croberson94/ILCS/README.md

# ILCS

## About
The Intelligent Lighting Control System (ILCS) is a Senior Design Capstone project made
to determine the proper lighting conditions for life on space stations in orbit. 

## Features
This project consists of providing a circadian lighting system in connection
with multiple sensors for various rooms of a 3D-printed scaled spacecraft model. 

## Download

## FAQ
