croberson94/ILCS/NTP_Clock/README.md

# NTP_Clock

## About
The NTP_Clock is 4Duino code that uses a connection to request and receive time from a NTP server using the User Datagram Protocol (UDP) communication protocol. The NTP_Clock base code can be found through the [4Duino Projects](http://www.4duino.com/ntp-clock/) . 

## Updates
This program is currently being modified to fit the needs of the ILCS Project.
