croberson94/ILCS/LaTeX Report/display/4Duino.png

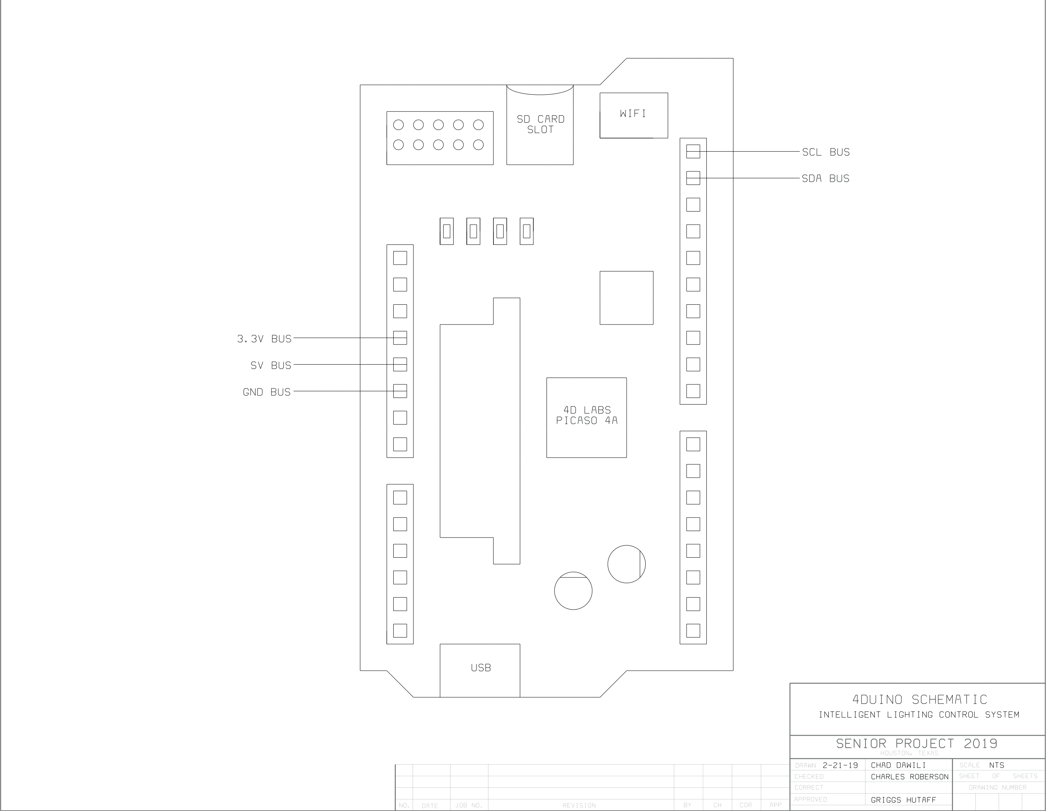
LaTeX Report/display/4Duino.png
