croberson94/ILCS/LaTeX Report/display/20190222_162111.jpg

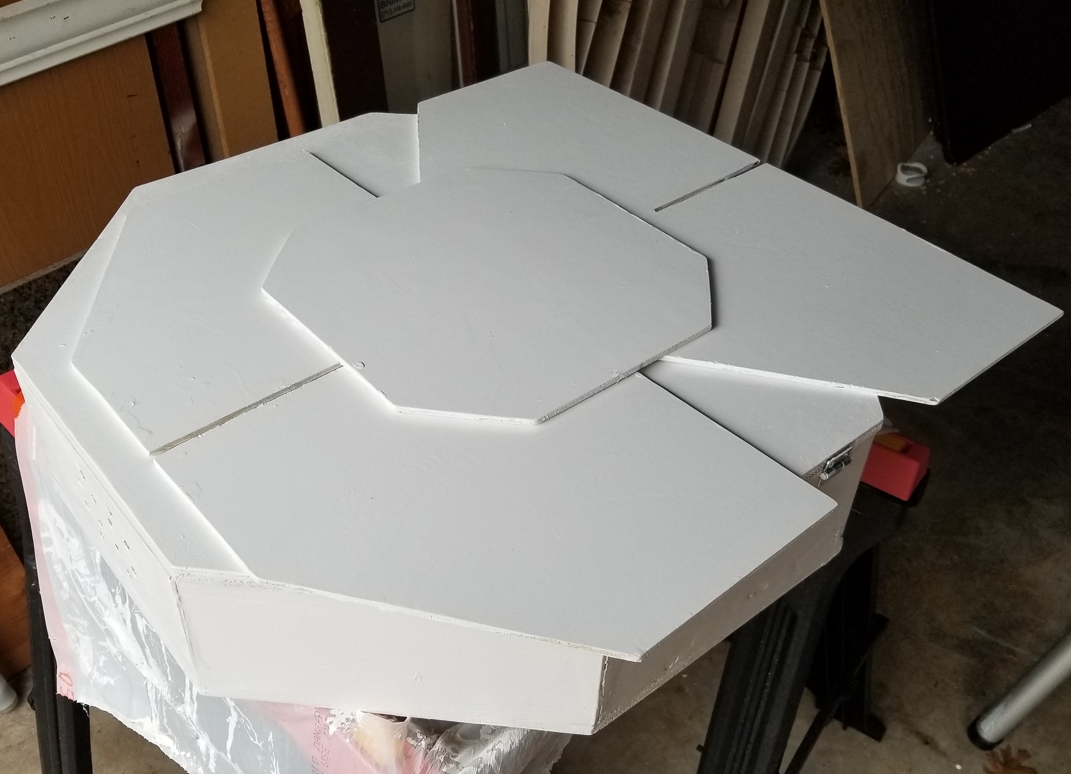
LaTeX Report/display/20190222_162111.jpg
