croberson94/ILCS/LaTeX Report/display/20190222_164352.jpg

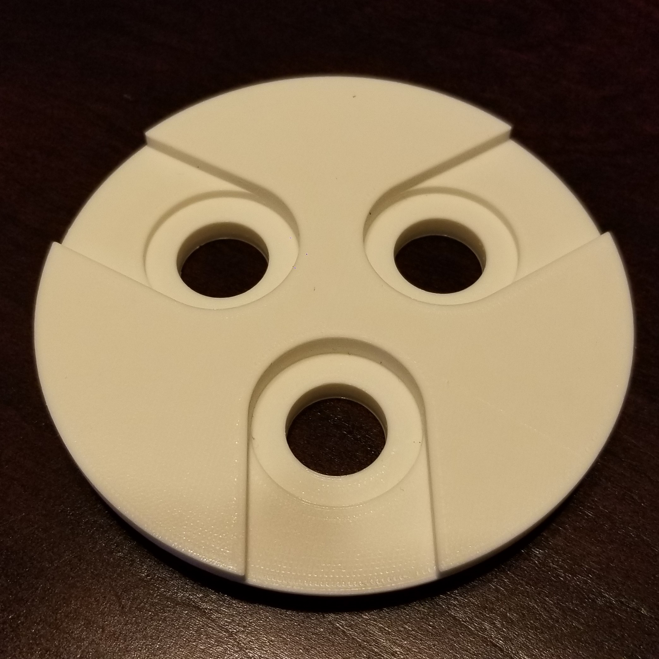
LaTeX Report/display/20190222_164352.jpg
