croberson94/ILCS/LaTeX Report/display/20190222_164402.jpg

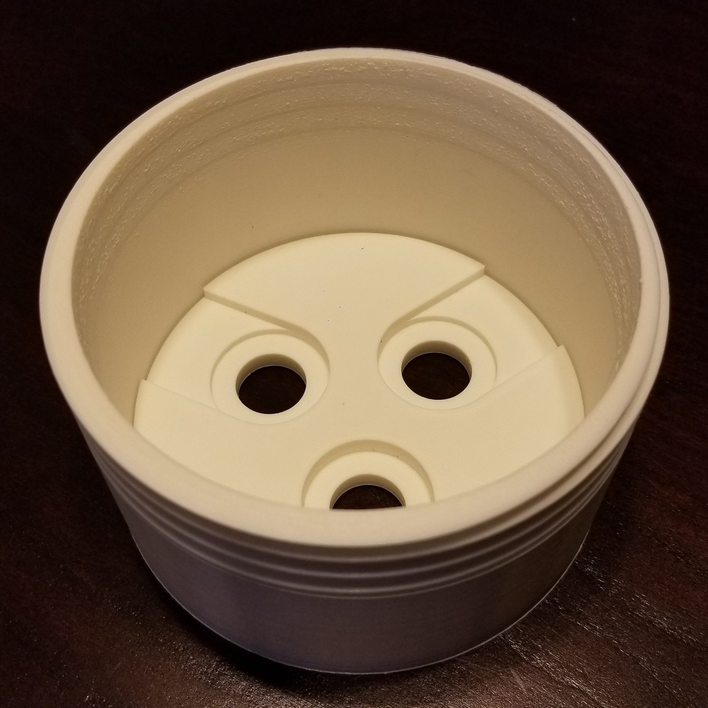
LaTeX Report/display/20190222_164402.jpg
