croberson94/ILCS/LaTeX Report/display/Arduino.png

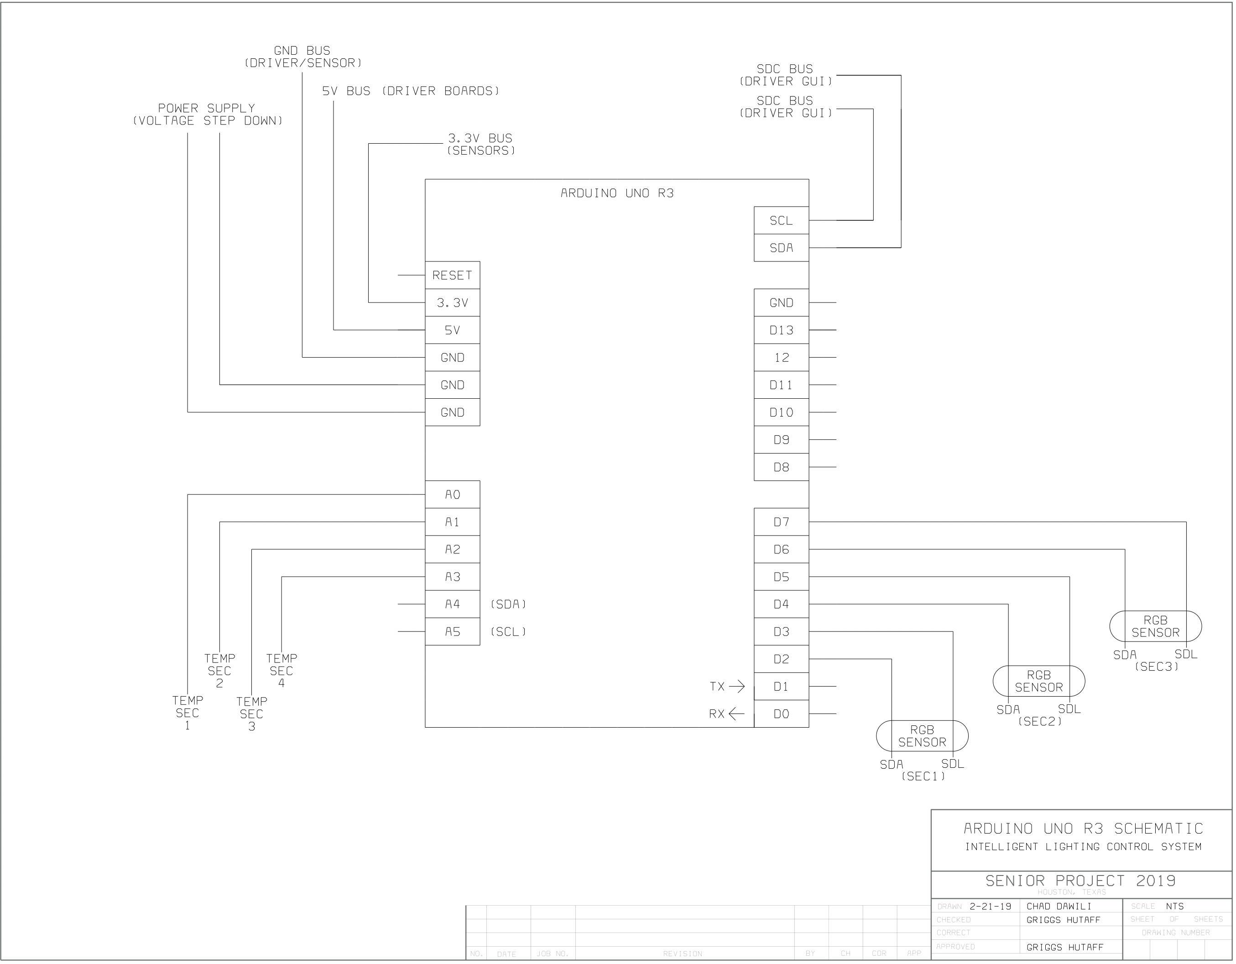
LaTeX Report/display/Arduino.png
