croberson94/ILCS/LaTeX Report/display/display model.PNG

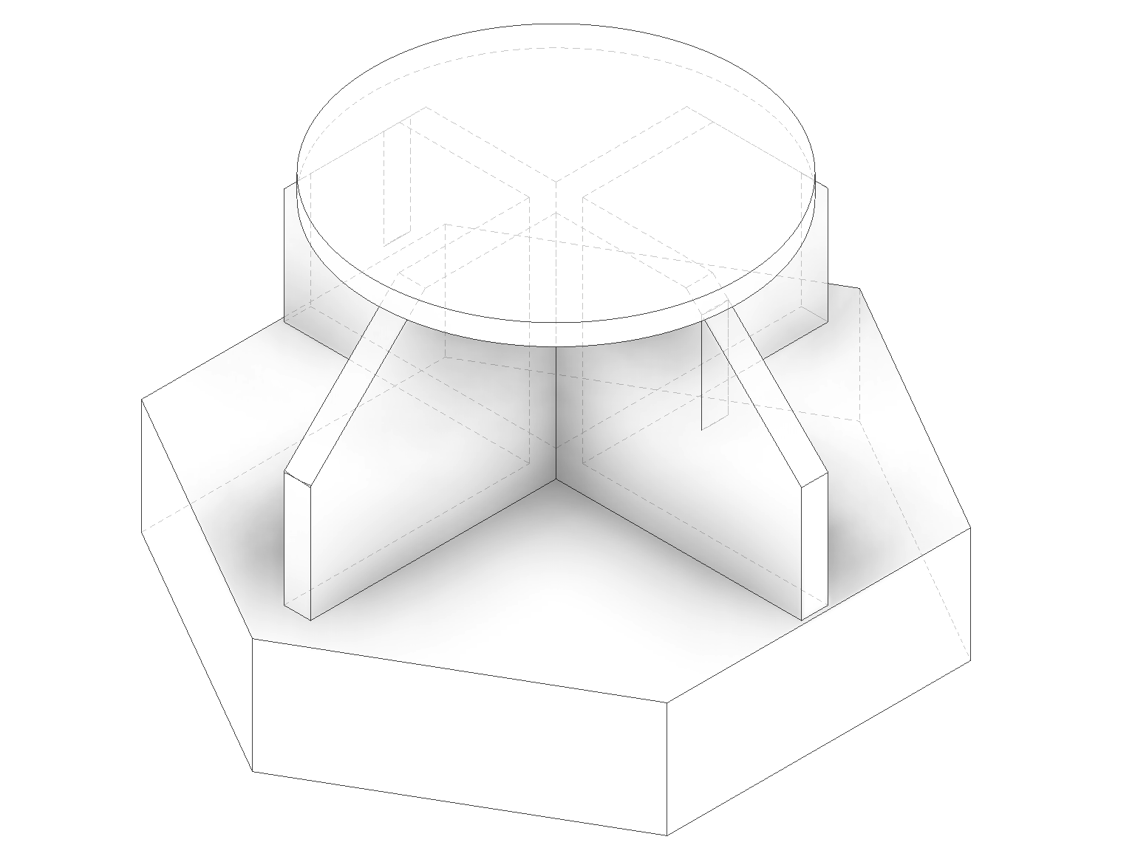
LaTeX Report/display/display model.PNG
