croberson94/ILCS/LaTeX Report/display/Infineon.png

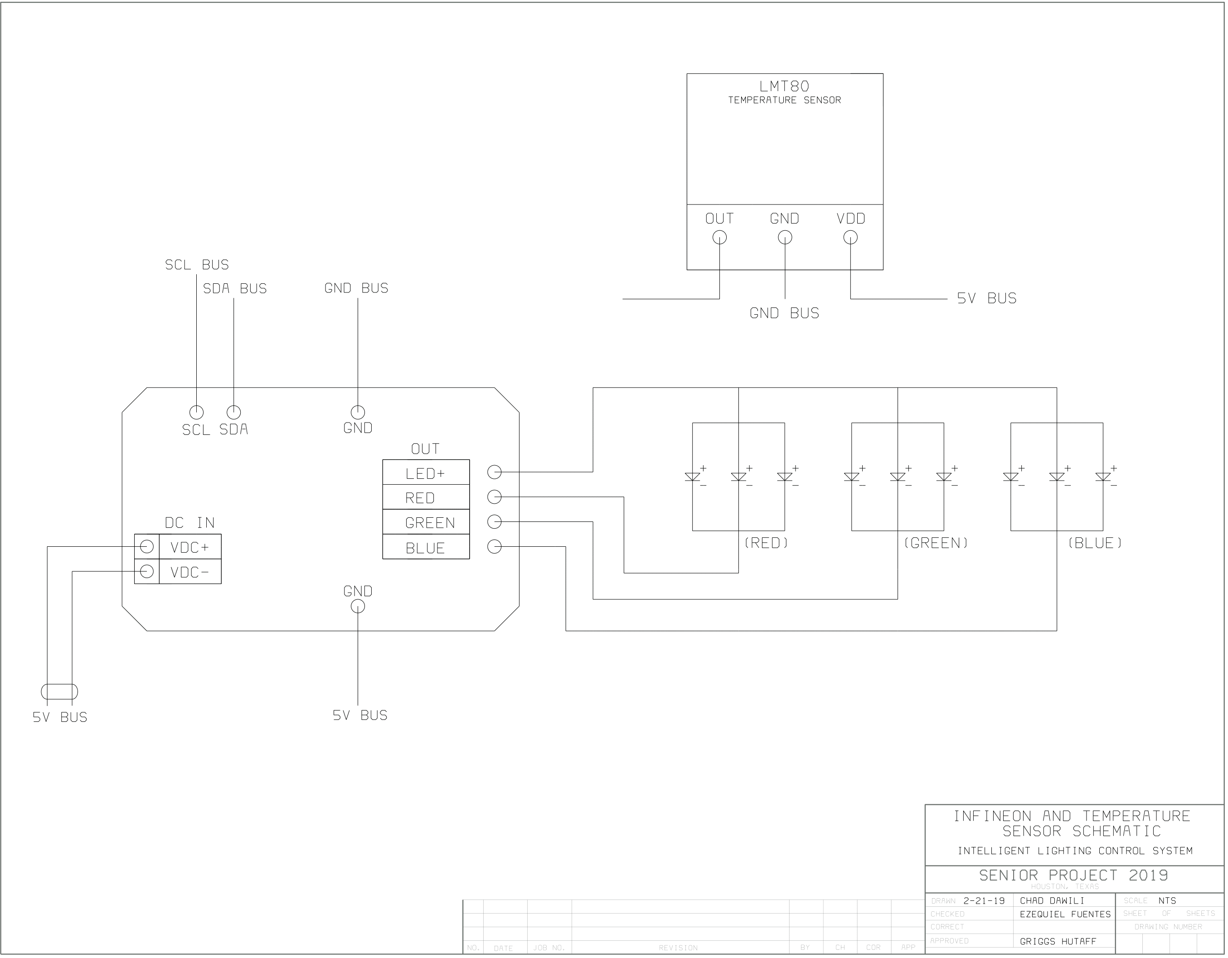
LaTeX Report/display/Infineon.png
