croberson94/ILCS/LaTeX Report/display/LightSensor.png

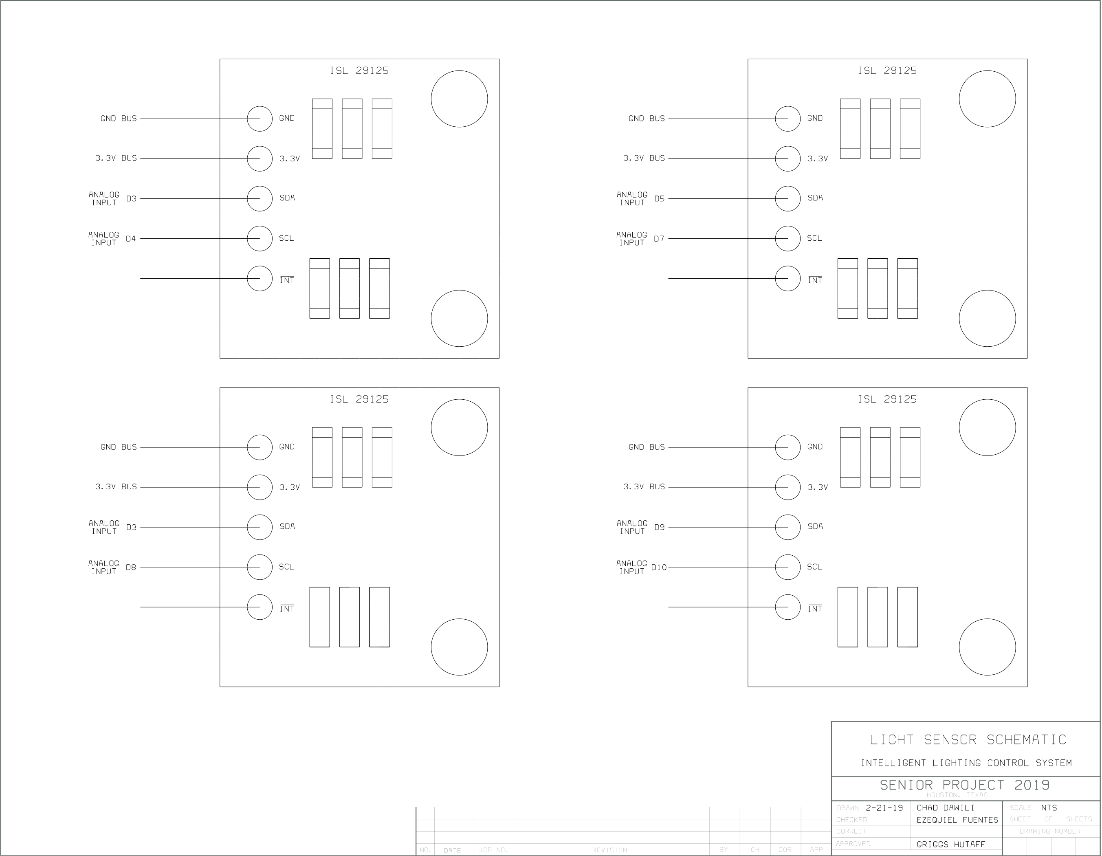
LaTeX Report/display/LightSensor.png
