croberson94/ILCS/LaTeX Report/display/model.jpg

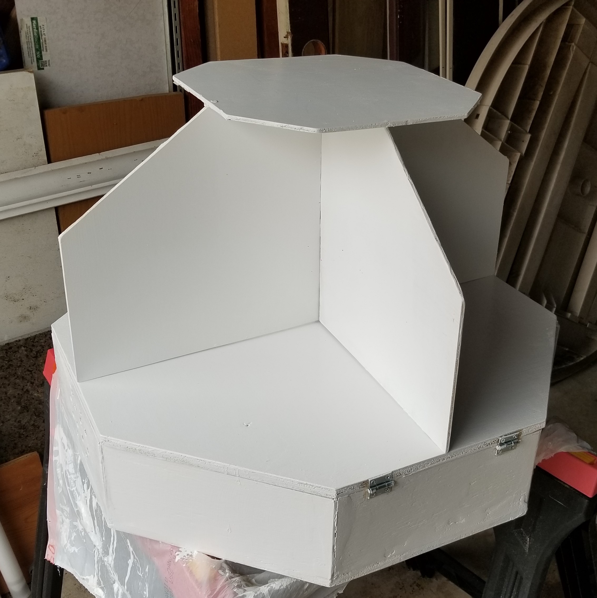
LaTeX Report/display/model.jpg
