croberson94/ILCS/LaTeX Report/display/Part1revised.PNG

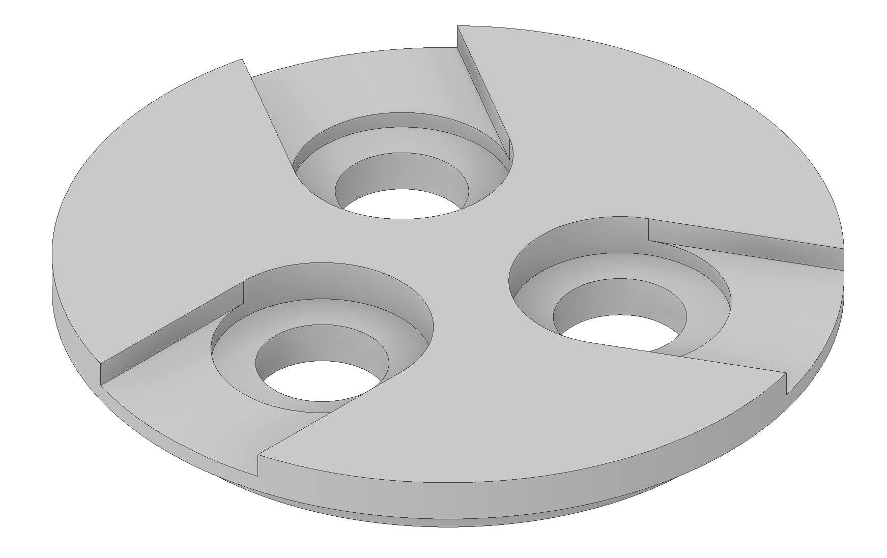
LaTeX Report/display/Part1revised.PNG
