croberson94/ILCS/LaTeX Report/display/Part1revisedwire.PNG

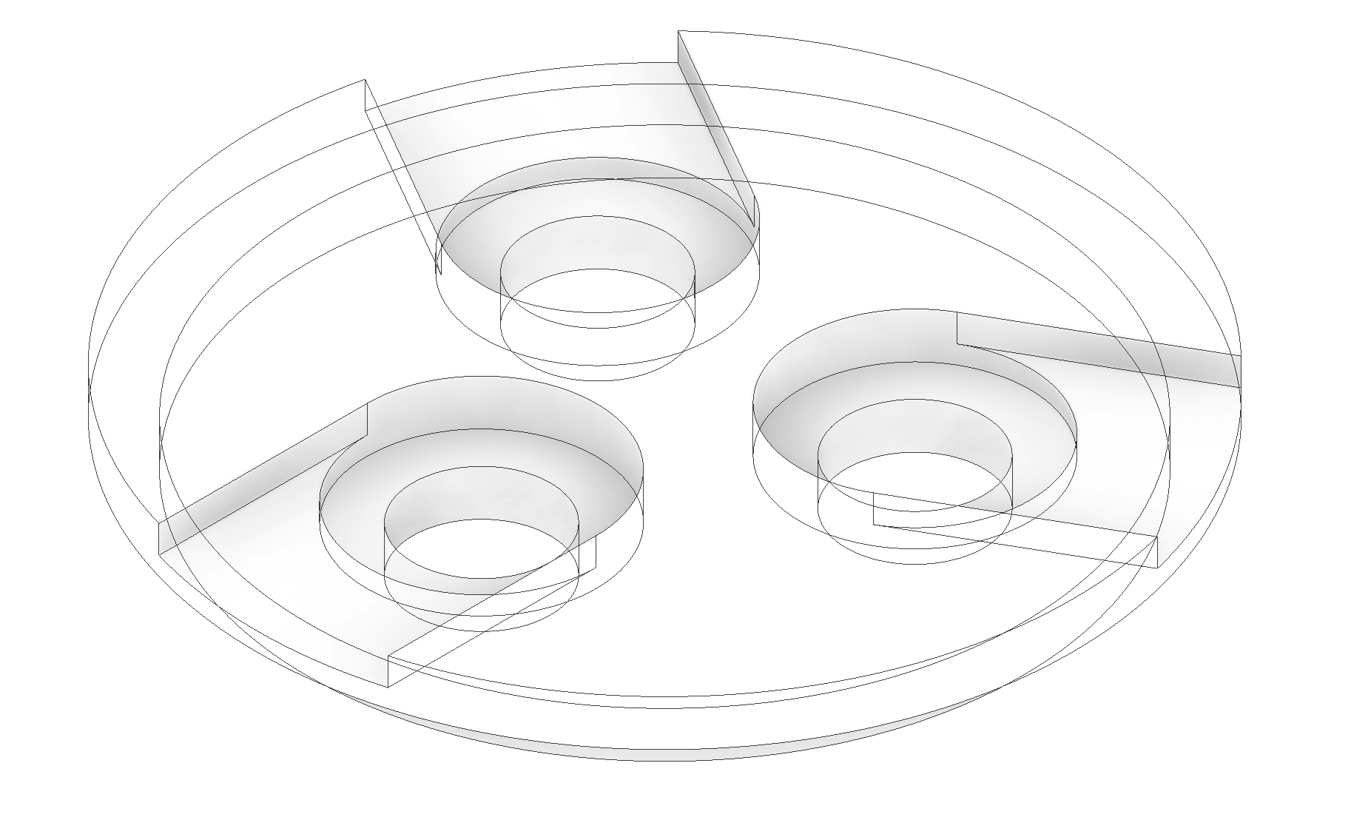
LaTeX Report/display/Part1revisedwire.PNG
