croberson94/ILCS/LaTeX Report/display/Part2revised.PNG

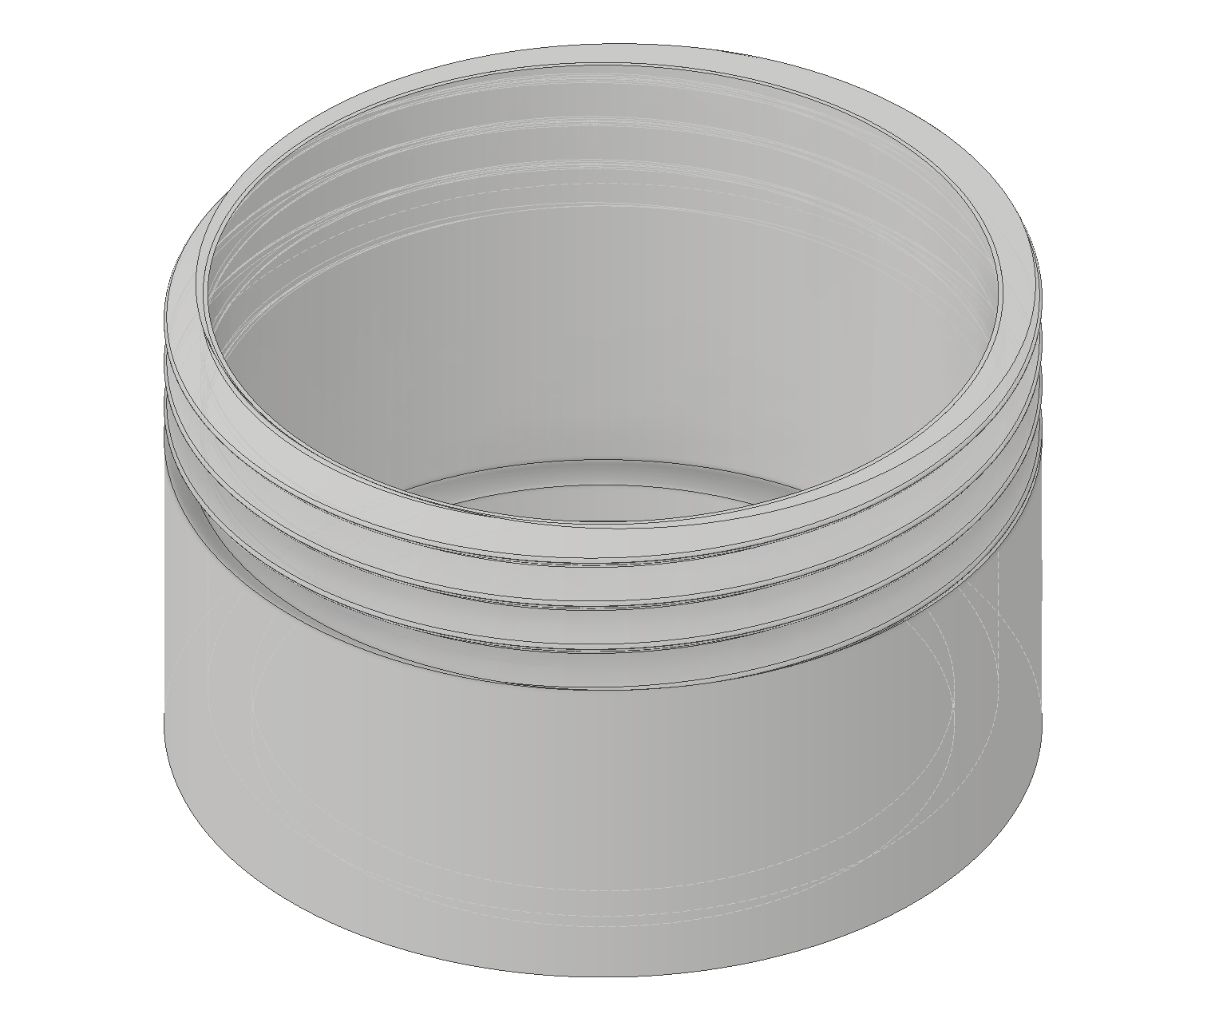
LaTeX Report/display/Part2revised.PNG
