croberson94/ILCS/LaTeX Report/display/Part2revisedwire.PNG

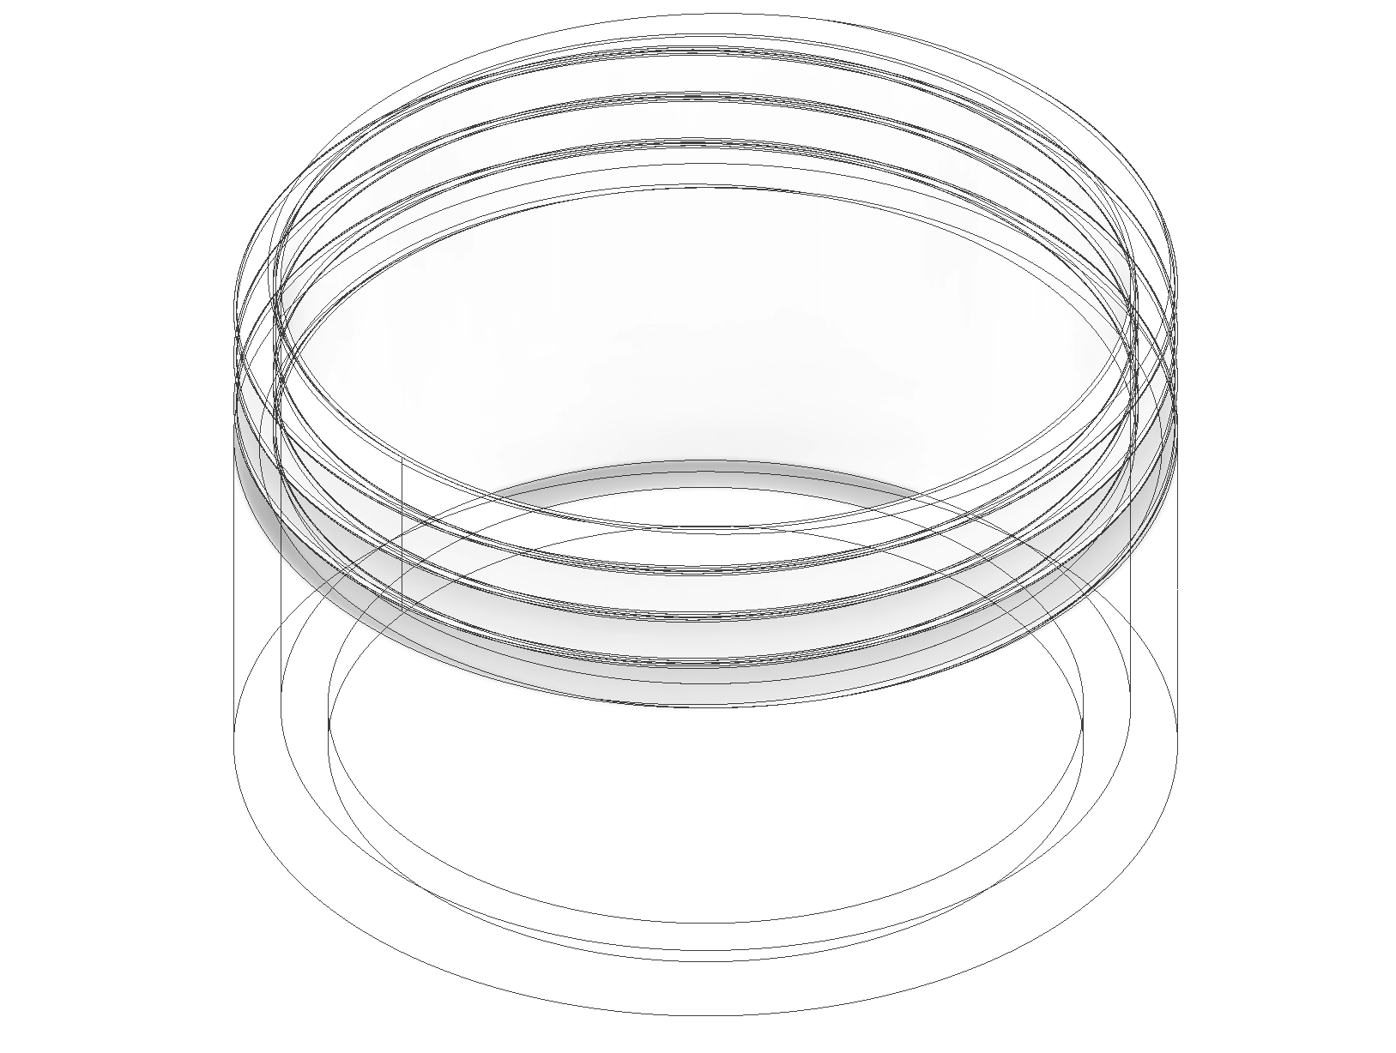
LaTeX Report/display/Part2revisedwire.PNG
