croberson94/ILCS/LaTeX Report/display/Part3revised.PNG

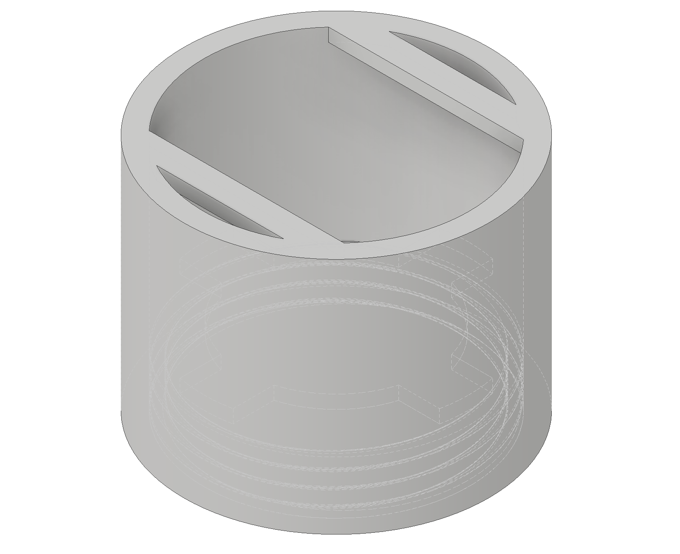
LaTeX Report/display/Part3revised.PNG
