croberson94/ILCS/LaTeX Report/display/Part3revisedwire.PNG

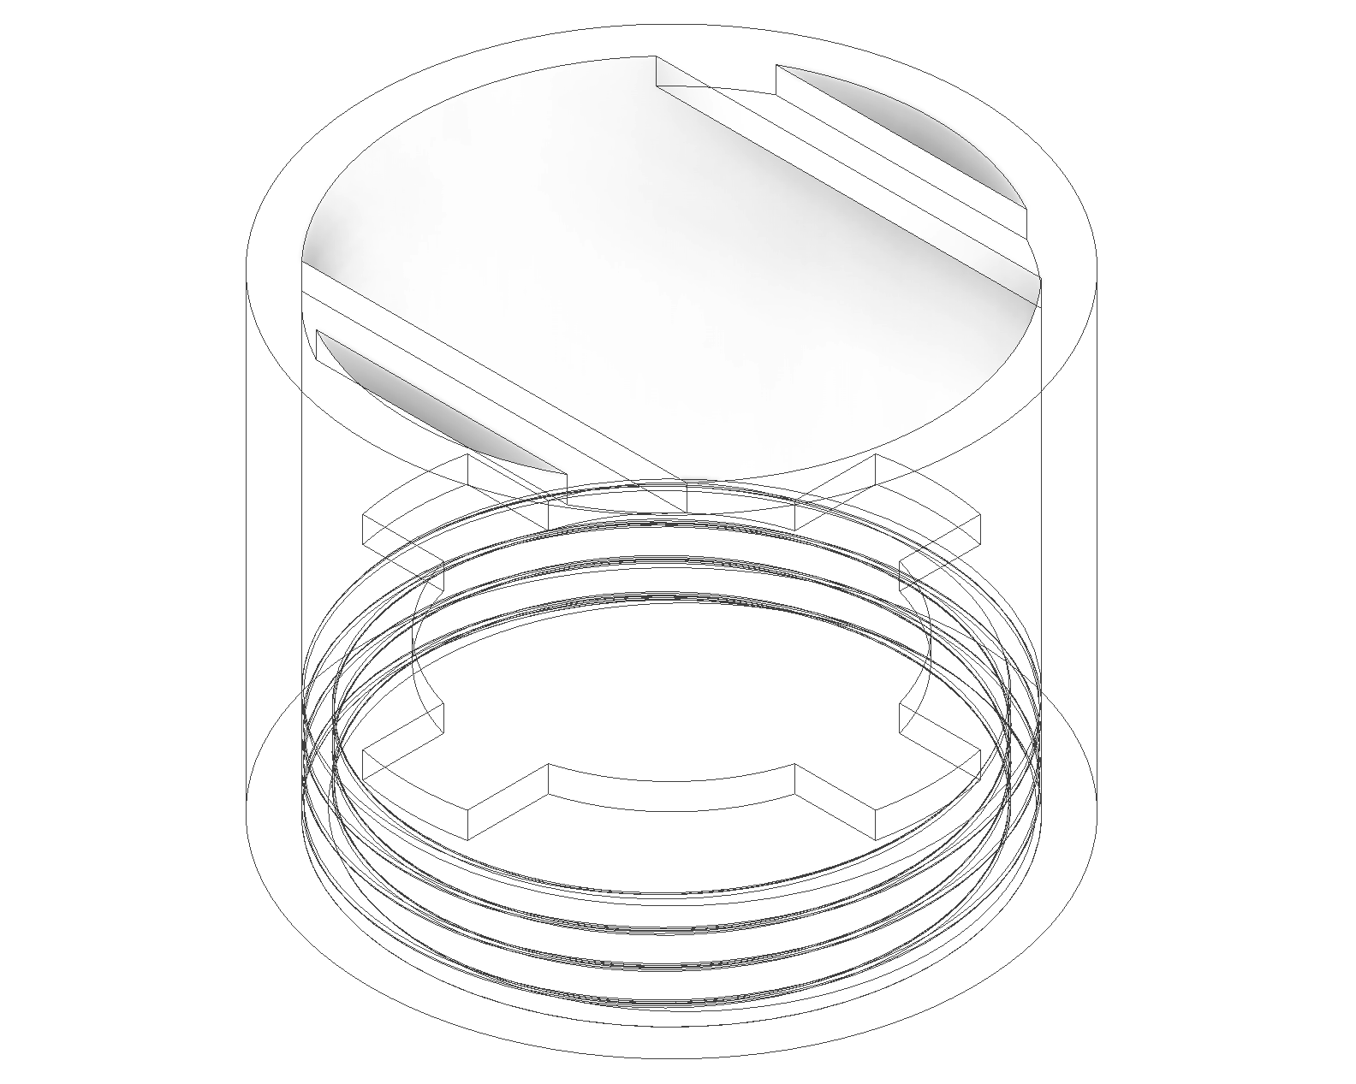
LaTeX Report/display/Part3revisedwire.PNG
