croberson94/ILCS/LaTeX Report/display/PowerSupply.png

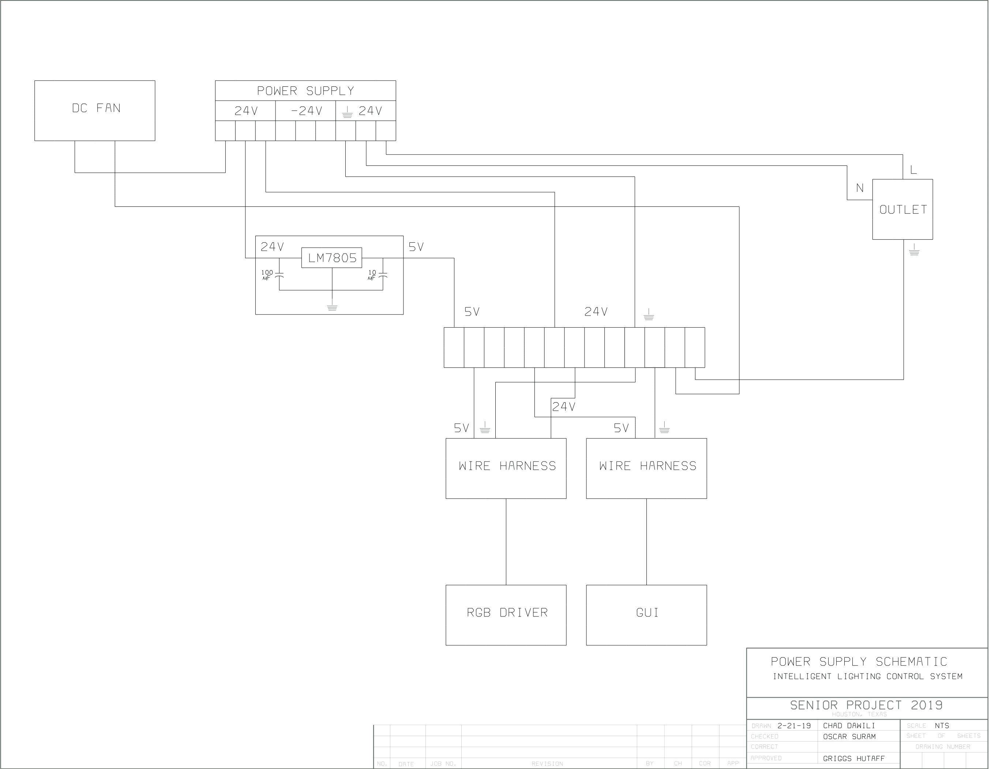
LaTeX Report/display/PowerSupply.png
