croberson94/ILCS/LaTeX Report/display/winbutton_final_release.PNG

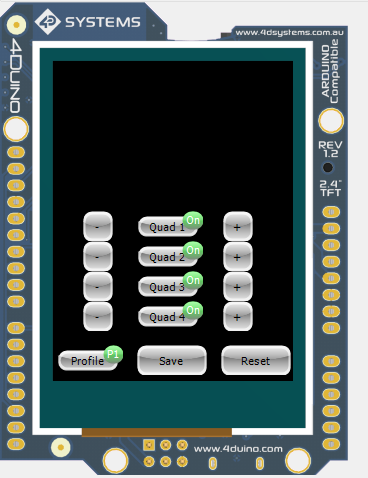
LaTeX Report/display/winbutton_final_release.PNG
