croberson94/ILCS/LaTeX Report/imgs/Buck.PNG

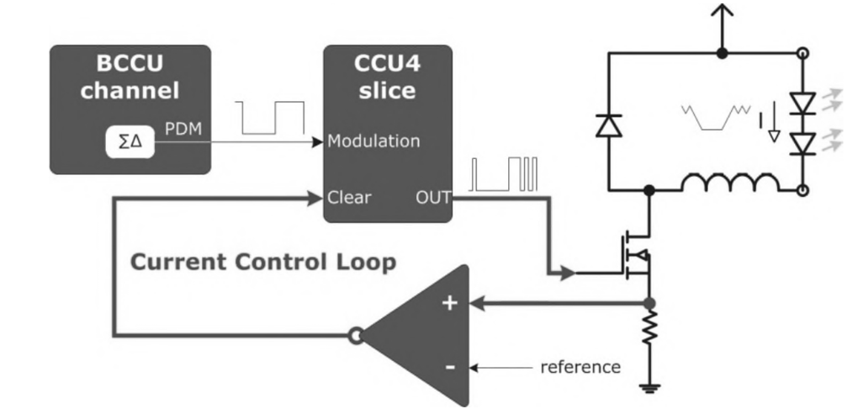
LaTeX Report/imgs/Buck.PNG
