croberson94/ILCS/LaTeX Report/imgs/ILCS_Flowchart.png

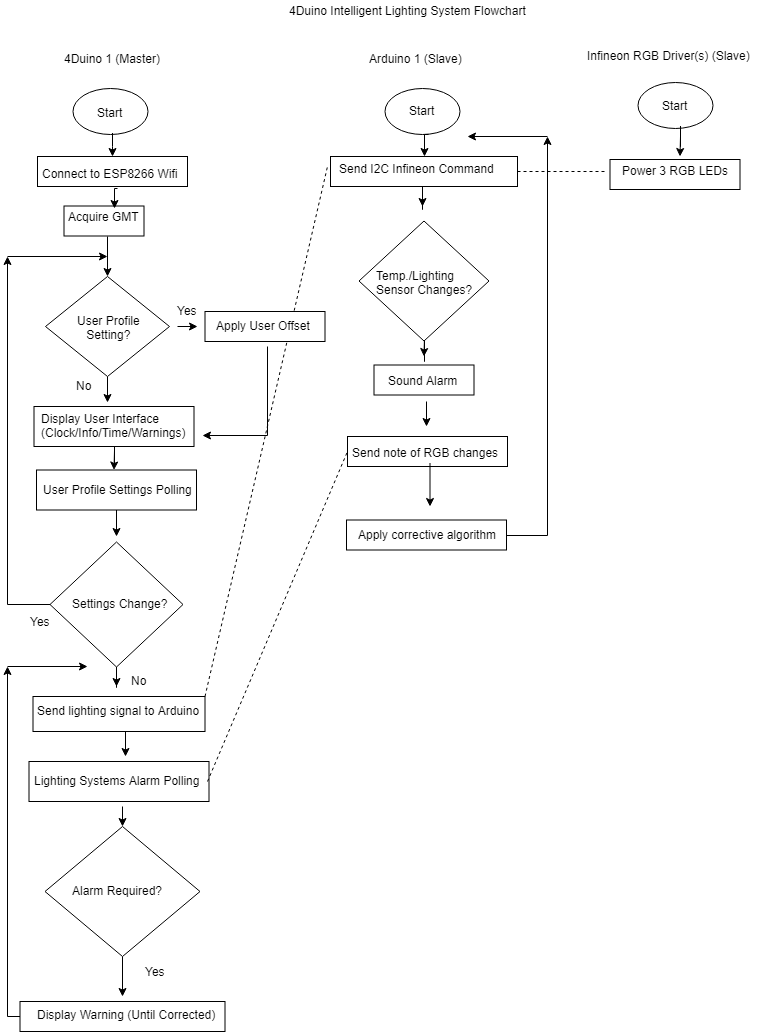
LaTeX Report/imgs/ILCS_Flowchart.png
