croberson94/ILCS/LaTeX Report/imgs/lightsense.PNG

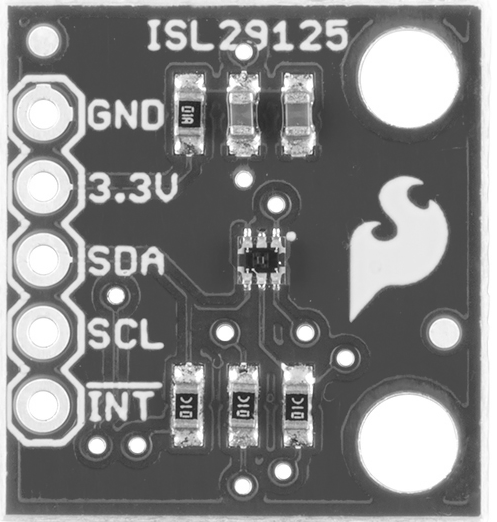
LaTeX Report/imgs/lightsense.PNG
