croberson94/ILCS/LaTeX Report/imgs/Part1curaBW.PNG

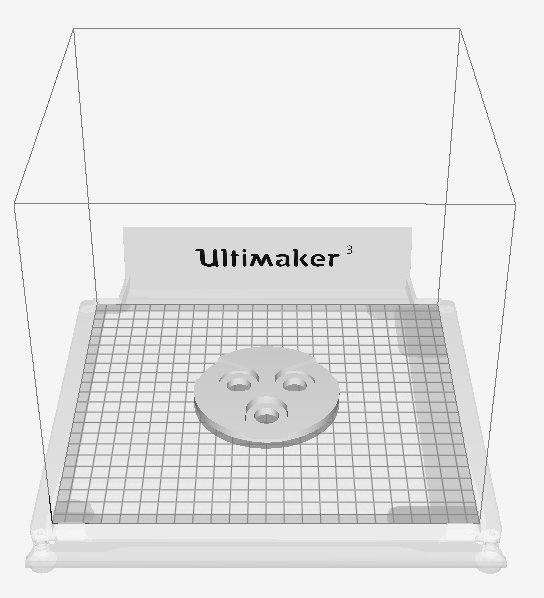
LaTeX Report/imgs/Part1curaBW.PNG
