croberson94/ILCS/LaTeX Report/imgs/Part2curaBW.PNG

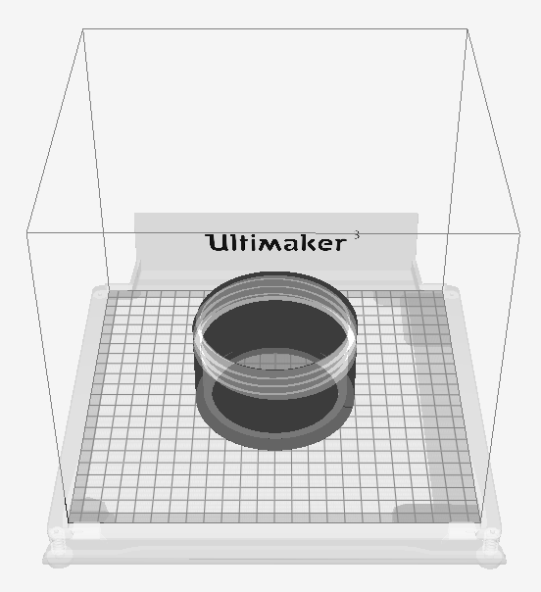
LaTeX Report/imgs/Part2curaBW.PNG
