croberson94/ILCS/LaTeX Report/imgs/Part3curaBW.PNG

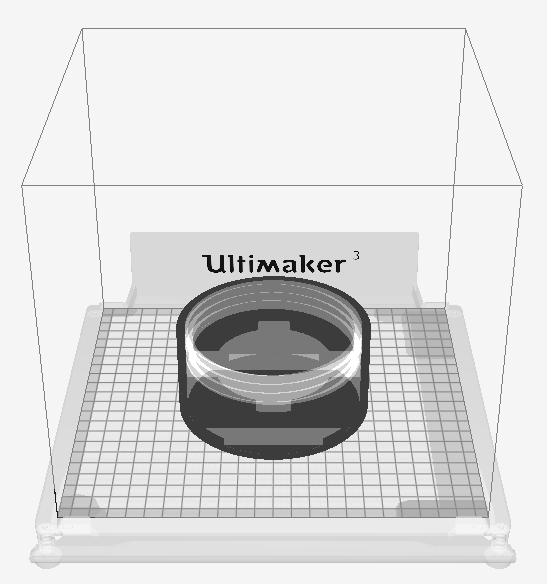
LaTeX Report/imgs/Part3curaBW.PNG
