croberson94/ILCS/LaTeX Report/imgs/tempsense.jpg

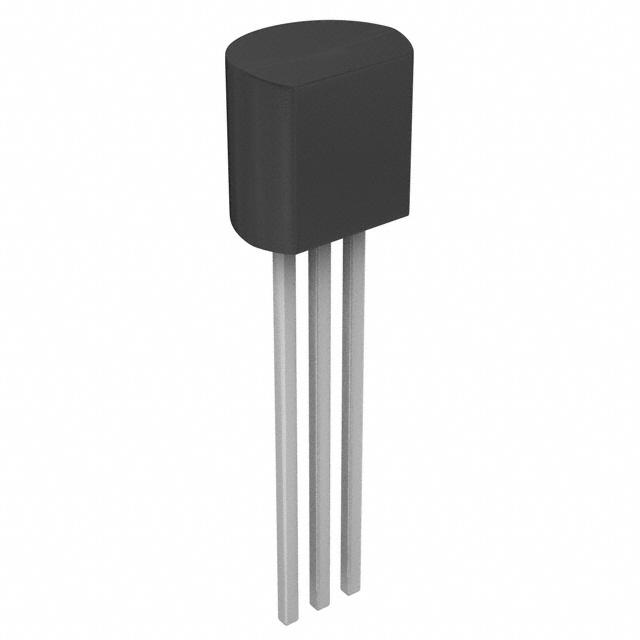
LaTeX Report/imgs/tempsense.jpg
