croberson94/ILCS/Development_Code/RGB_Driver_Dev/RGB_Driver_Dev.ino

/*
 * The University of Texas at Tyler
 * Intelligent Lighting Control System Team
 * 
 * Purpose:       This script builds circadian cycles and sends commands
 *                to the infineon RGB LED Lighting shield
 *                
 * Author:        Griggs Hutaff
 * 
 * Last Revision: 02/06/2019
 * 
 */





#include <RGBLEDLighting.h>
#include <Wire.h>

InfineonRGB LEDS;  // Create Object

  //declare all variables needed

//  int intensity_red, intensity_green, intensity_blue;
//  int current_red, current_green, current_blue;
//  int sensor_red, int sensor_green, int sensor_blue;
//  int tempsens1, int tempsens2, int tempsens3, int tempsens4;
//  int sctr1_addr, sctr2_addr, sctr3_addr, sctr4_addr;
    int sctr1_addr = 0x15E;
    int sctr2_addr = 0x15D;
    int sctr3_addr = 0x15C;
    int sctr4_addr = 0x15B;
    
    int offtime_read;
/*
 * time_multiplier allows us to quickly adjust the cycle run time,
 * the multipliers will be in orders of 10:
 * 1 = 6sec cycle
 * 10 = 60 sec cycle
 * 100 = 10 minutes
 * 600 = 1 hour
 * 14,400 = 24 hours
 */
    float time_multiplier1;
    float time_multiplier2;
    float time_multiplier3;
    float time_multiplier4;

/*
 * dimming values will be placed in an array, this array may be prestored during  
 * development OR this array may be generated by an algorithm based on initial conditions
 * and time constraints
 */
    //int dimming_array[] = {0x19A,0x332,0x4CC,0x665,0x7FF,0x998,0xB31,0xCCB,0xE64,0xFFF};
    char* percent_array[] = {"10%","20%","30%","40%","50%","60%","70%","80%","90%","100%"};
    int dimming_array[] = {0x0,0x0,0x0,0x19A,0x4CC,0x665,0x998,0xCCB,0xFFF,0xFFF};
    int current[]= {0x0,0x0,0x0,0x2D,0x2D,0x2D,0x2D,0x2D,0x2D,0x2D};
    int offtime[] = {0xFF,0xFF,0xFF,0x28,0x28,0x28,0x28,0x28,0x28,0x28};
     
/*
 * Color intensities will also need to be put in any array, this is more challenging because
 * we will have a 2 dimentional list
 */
    int day_intense[3] = {0x555,0x555,0x555};
    int morning_intense[3] = {0x555,0x555,0x555};
    int night_intense[3] = {0x0,0x0,0x0};
    int red_intense[10] = {night_intense[0],night_intense[0],night_intense[0],morning_intense[0],morning_intense[0],
    day_intense[0],day_intense[0],day_intense[0],day_intense[0],day_intense[0]};
    
    int green_intense[10] = {night_intense[1],night_intense[1],night_intense[1],morning_intense[1],morning_intense[1],
    day_intense[1],day_intense[1],day_intense[1],day_intense[1],day_intense[1]};
    
    int blue_intense[10] = {night_intense[2],night_intense[2],night_intense[2],morning_intense[2],morning_intense[2],
    day_intense[2],day_intense[2],day_intense[2],day_intense[2],day_intense[2]};

/*
 * Create constants to be used for interrupts, these numbers correspond to Mega pins
 */
    const byte interruptPin1 = 2;
    const byte interruptPin2 = 3;
    const byte interruptPin3 = 21;
    const byte interruptPin4 = 20;
    
void setup() {

   Serial.begin(38400); // Starts the serial connection at 38400 baud

/*
 * For now it seems that Wire.begin() is the only usable function to come out of the LEDS.begin() class,
 * as we proceed we may have to look again to see if we need to anything else to the driver initialization
 */
       
  Wire.begin();

  /*
   * Define interrupts, we will make an interrupt for each light fixture these
  // */
  //attachInterrupt(digitalPinToInterrupt(interruptPin1,isrSector1,RISING));
  //attachInterrupt(digitalPinToInterrupt(interruptPin2,isrSector2,RISING));
  //attachInterrupt(digitalPinToInterrupt(interruptPin3,isrSector3,RISING));
  //attachInterrupt(digitalPinToInterrupt(interruptPin4,isrSector4,RISING));
  //Wire.onReceive(GUIhandler);
  //
/*
 * WALKTIME:
 *The RGB LED Shield calculates the actual linear walktime with the formula:
 *Linear Walk Time = WALKTIME * 0.0124
  */
  
  LEDS.I2CWRITE2BYTES(sctr1_addr,WALKTIME,0x186);  // Set walk time to 2 seconds
/*
 * DIMMING LEVEL:
 * The curve is quantized into 4095 steps, pseudo exponential curve.
 * *NOTE* The brightness value of a channel = intesity*diming level/4096
 */
   //LEDS.I2CWRITE2BYTES(sctr1_addr,DIMMINGLEVEL,0x19A); // 10% Brightness
   //LEDS.I2CWRITE2BYTES(sctr1_addr,DIMMINGLEVEL,0x555); //50% brightness
   //LEDS.SetDimmingLevel(0x0555);

/* 
 *  Current Level maximum is 0x80
 */
   LEDS.I2CWRITE2BYTES(sctr1_addr,CURRENT_RED, 0x2D);
   LEDS.I2CWRITE2BYTES(sctr1_addr,CURRENT_BLUE, 0x2D);
   LEDS.I2CWRITE2BYTES(sctr1_addr,CURRENT_GREEN, 0x2D);
   LEDS.I2CWRITE2BYTES(sctr1_addr,FADERATE,0xFFFF);  // Set faderate

   //set offtime
   LEDS.I2CWRITE2BYTES(sctr1_addr,OFFTIME_RED, 0x28);
   LEDS.I2CWRITE2BYTES(sctr1_addr,OFFTIME_GREEN, 0x28);
   LEDS.I2CWRITE2BYTES(sctr1_addr,OFFTIME_BLUE, 0x28);
}

void loop() {
  Serial.println("The Loop is reset");
  //LEDS.SetIntensityRGB(0x0555, 0x0555, 0x0555);
  time_multiplier1 = 10;
  for (int i = 0; i<10;i++)
  {
    LEDS.SetIntensityRGB(red_intense[i], green_intense[i], blue_intense[i]);
    LEDS.I2CWRITE2BYTES(sctr1_addr,DIMMINGLEVEL,dimming_array[i]);
    LEDS.I2CWRITE2BYTES(sctr1_addr,CURRENT_RED,current[i]);
    LEDS.I2CWRITE2BYTES(sctr1_addr,CURRENT_GREEN,current[i]);
    LEDS.I2CWRITE2BYTES(sctr1_addr,CURRENT_BLUE,current[i]);
    LEDS.I2CWRITE2BYTES(sctr1_addr,OFFTIME_RED,offtime[i]);
    LEDS.I2CWRITE2BYTES(sctr1_addr,OFFTIME_GREEN,offtime[i]);
    LEDS.I2CWRITE2BYTES(sctr1_addr,OFFTIME_BLUE,offtime[i]);
    Serial.print("The Brightness is ");
    Serial.println(percent_array[i]);
    Serial.println(dimming_array[i]);
    offtime_read = LEDS.I2CREAD(sctr1_addr,READ_OFFTIME_RED);
    Serial.print("The offtime for read channel is ");
    Serial.println(offtime_read);
//    Serial.println(local_day[1]);
//    Serial.println(local_day[2]);
//    Serial.println(local_day[3]);
    delay(300*time_multiplier1);
  }
  for (int i= 9;i>1;i--)
  { 
    LEDS.SetIntensityRGB(red_intense[i], green_intense[i], blue_intense[i]);
    LEDS.I2CWRITE2BYTES(sctr1_addr,DIMMINGLEVEL,dimming_array[i-1]);
    Serial.print("The Brightness is ");
    Serial.println(percent_array[i-1]);
    Serial.println(dimming_array[i-1]);
    delay(300*time_multiplier1);
  }
  

}
/*
void GUIhandler(byte 1){
  byte code = Wire.read();
  byte lightcode = code & 0x7;
  switch (lightcode){
    case '0x1':
      isrSector1();
      break;
    case '0x2':
      isrSector2();
      break;
    case '0x3':
      isrSector3();
      break;
    case '0x4':
      isrSector4();
      break;
  }
  
}
void isrSector1() {
  // change or initialize sector1 light fixture
}

void isrSector2() {
  // change or initialize sector2 light fixture
}

void isrSector3() {
  // change or initialize sector3 light fixture
}

void isrSector4() {
  // change or initialize sector4 light fixture
}
*/
