croberson94/ILCS/SFE_ISL29125_Library/examples/ISL29125_basics/ISL29125_basics.ino

/******************************************************************************
ISL29125_basics.ino
Simple example for using the ISL29125 RGB sensor library.
Jordan McConnell @ SparkFun Electronics
11 Apr 2014
https://github.com/sparkfun/ISL29125_Breakout

This example declares an SFE_ISL29125 object called RGB_sensor. The 
object/sensor is initialized with a basic configuration so that it continuously
samples the light intensity of red, green and blue spectrums. These values are
read from the sensor every 2 seconds and printed to the Serial monitor.

Developed/Tested with:
Arduino Uno
Arduino IDE 1.0.5

Requires:
SFE_ISL29125_Library

This code is beerware.
Distributed as-is; no warranty is given. 
******************************************************************************/

#include <Wire.h>
#include "SFE_ISL29125.h"

// Declare sensor object
SFE_ISL29125 RGB_sensor;

void setup()
{
  // Initialize serial communication
  Serial.begin(115200);

  // Initialize the ISL29125 with simple configuration so it starts sampling
  if (RGB_sensor.init())
  {
    Serial.println("Sensor Initialization Successful\n\r");
  }
  else{
    Serial.println("Sensor Initialization Failed\n\r");
  }
}

// Read sensor values for each color and print them to serial monitor
void loop()
{
  // Read sensor values (16 bit integers)
  unsigned int red = RGB_sensor.readRed();
  unsigned int green = RGB_sensor.readGreen();
  unsigned int blue = RGB_sensor.readBlue();
  
  // Print out readings, change HEX to DEC if you prefer decimal output
  Serial.print("Red: "); Serial.println(red,HEX);
  Serial.print("Green: "); Serial.println(green,HEX);
  Serial.print("Blue: "); Serial.println(blue,HEX);
  Serial.println();
  delay(2000);
}
