croberson94/ILCS/(commit log)

2019-02-06 latest RGB driver code
2019-02-07 Library Recommend by Dr. R - Allows I2C communication on all pins
2019-02-11 Addition of final light sensor library and working light sensor code
2019-02-18 Latest RGB Driver Code along with I2C Master/Slave for uP to GUI communication
2019-02-22 Added Images for Schematics
2019-02-23 added schematics and filepaths for figures
2019-02-23 Added sensor section
2019-02-23 new images for sensors
2019-03-01 updated request isr for switch statement
2019-03-25 Added the BOM to section 4 that chad created
2019-04-01 Added the Master Code for the Lighting System Arduino
2019-04-06 updated master driver code
2019-04-10 Slave Production Code for 4 arduinos
2019-04-10 changed file name to correct sector
    [Sector3_address154.ino]
2019-04-12 added sensor codes to Master Code
2019-04-18 Voltage Regulation update
2019-04-19 added section on centrally controlled sensors as well as appendix B
2019-04-19 BOM Update
